phisn/DigitalDetectives/Architecture/Device_Layer_Detail.jpeg

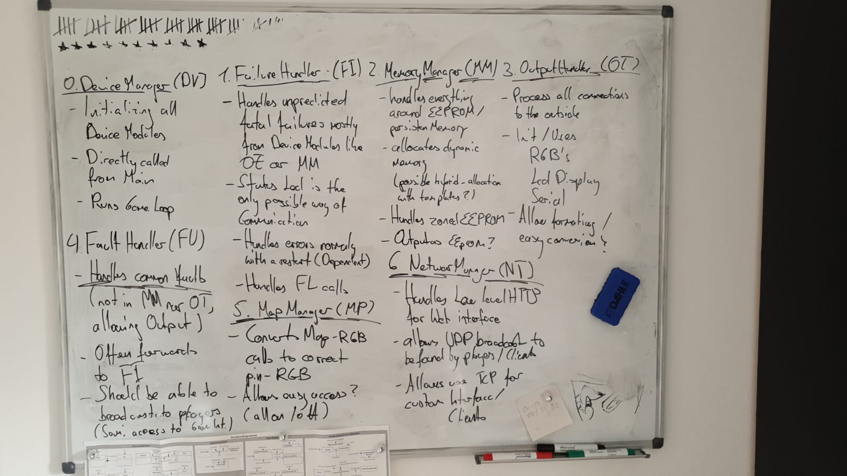
Architecture/Device_Layer_Detail.jpeg
