phisn/DigitalDetectives/Architecture/Combined_Layers.jpeg

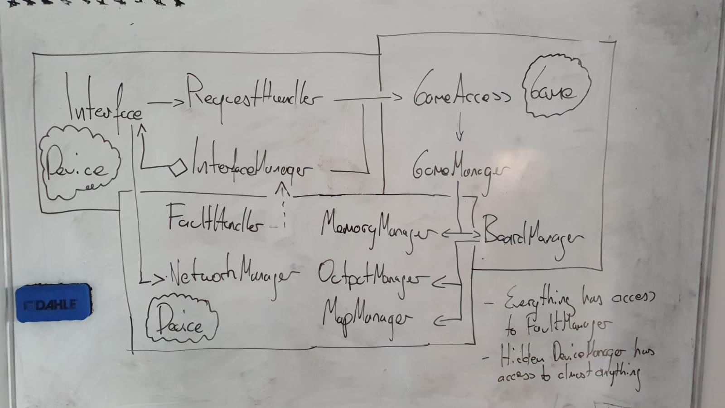
Architecture/Combined_Layers.jpeg
