phisn/DigitalDetectives/Architecture/BootConcept.jpeg

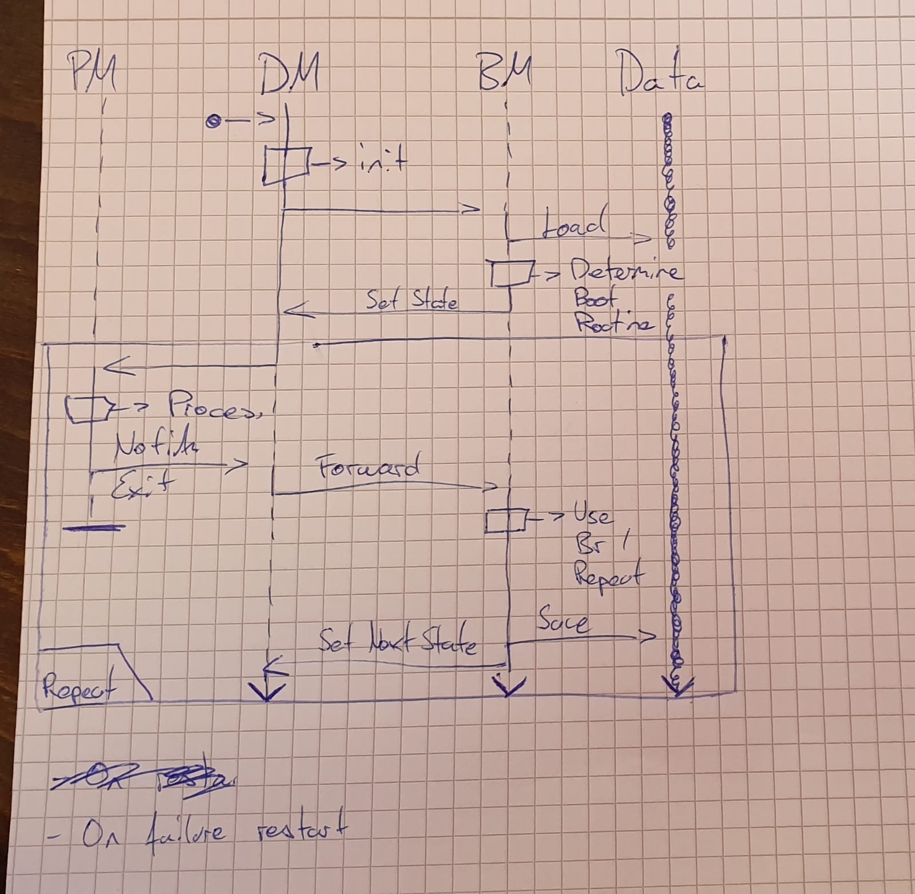
Architecture/BootConcept.jpeg
