phisn/DigitalDetectives/Architecture/Communication_Layer.jpeg

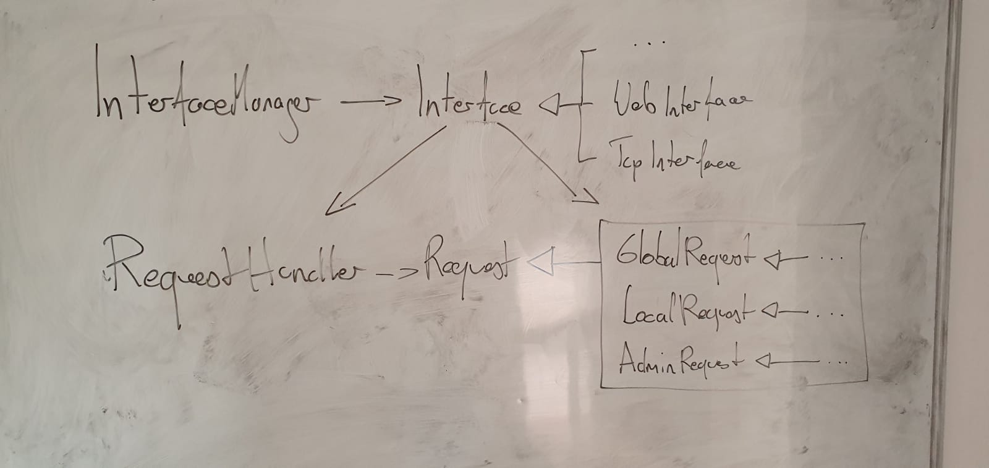
Architecture/Communication_Layer.jpeg
