phisn/DigitalDetectives/Architecture/Device_Layer.jpeg

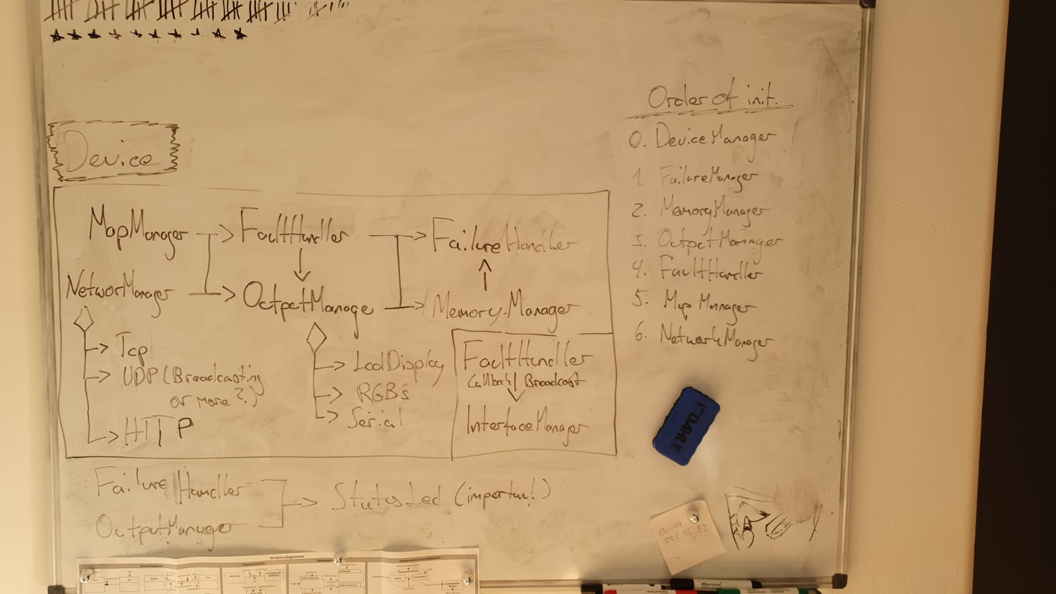
Architecture/Device_Layer.jpeg
