phisn/DigitalDetectives/Architecture/Game_Layer2.jpeg.jpg

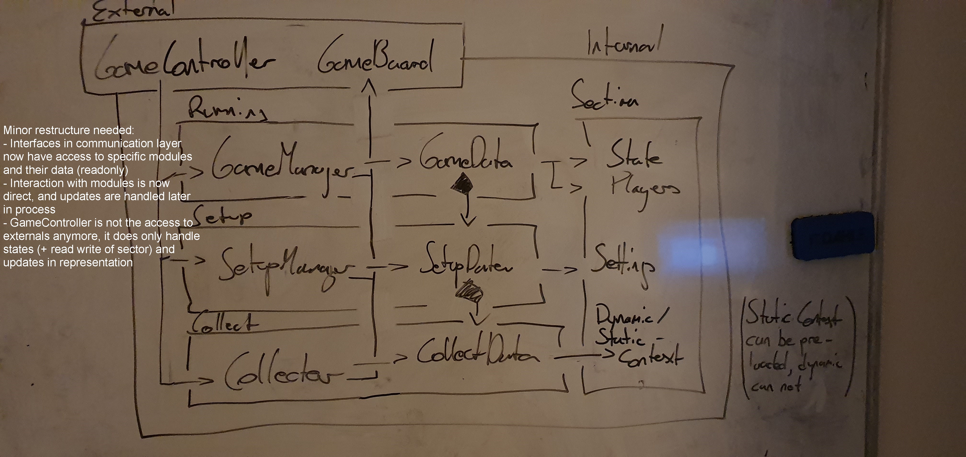
Architecture/Game_Layer2.jpeg.jpg
