phisn/DigitalDetectives/Architecture/Game_Layer.jpeg

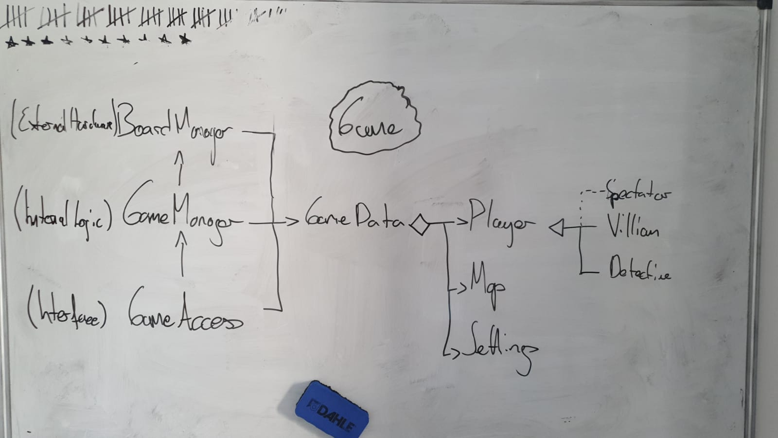
Architecture/Game_Layer.jpeg
