phisn/DigitalDetectives/Architecture/Overall_Progress.jpeg

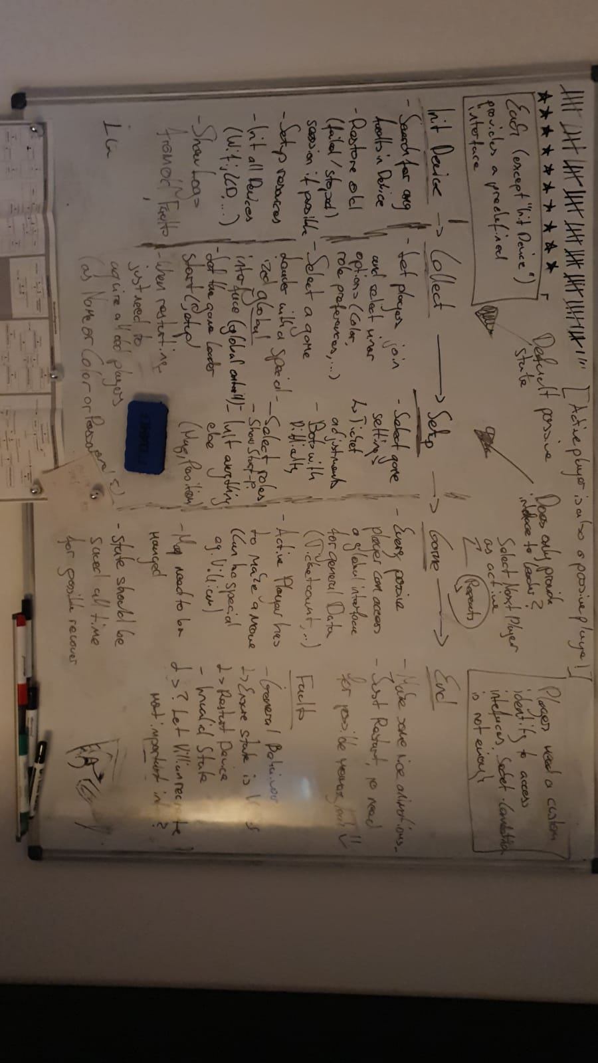
Architecture/Overall_Progress.jpeg
