phisn/DigitalDetectives/Docs/SY_Map.png

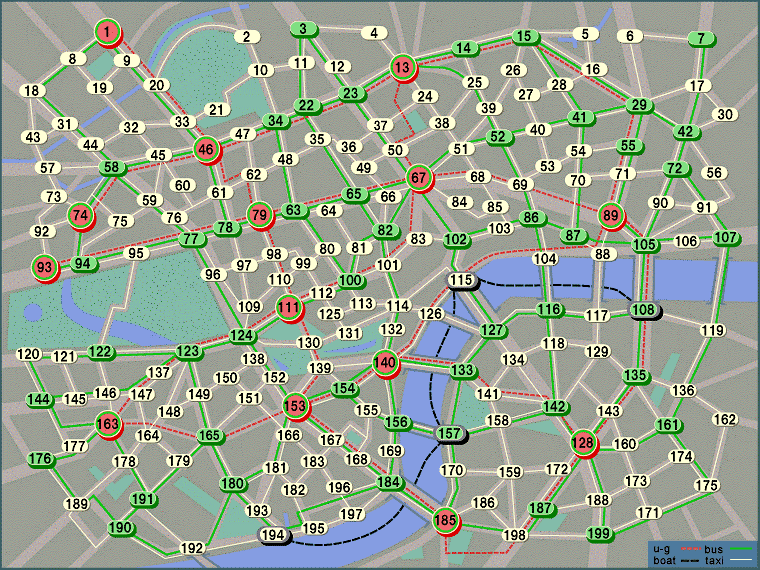
Docs/SY_Map.png
