phisn/DigitalDetectives/Docs/SY_Map_Splitted.jpeg

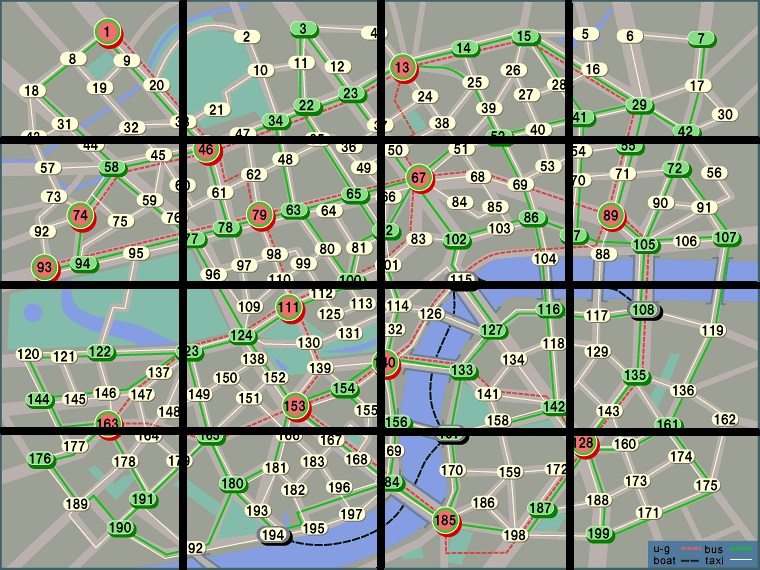
Docs/SY_Map_Splitted.jpeg
