phisn/DigitalDetectives/Source/Web/Modular/setup_body.txt

<body> <div class="container"> <h3>Please wait...</h3> <i>Your Player-ID is <b id="pid"></b></i> </div></body>
