phisn/DigitalDetectives/(commit log)

2019-08-15 Device Layer Initialize
2019-08-22 Global Namespace and Include fix
    [Main.ino]
2019-09-04 MemoryManger update, PathManger rename, general bug fixs
    [Main.ino]
2019-09-04 Bootmanager init, FaultHandler device validation init
2019-09-04 BootManager update, FaultHandler Report init & Validate update, DeviceManager Forward
2019-09-19 Fixed Typo in DeviceManager (InitializeGame)
2019-09-19 Added Current Villian Position to Web
2019-09-20 MememoryManager update, Outpmanager and Networkmanager Object error fix, DebugMessages
    [Main.ino]
2019-10-14 Interfacemanager fault notifier update, Interfacemanager process update including DeviceManager processing
2019-10-19 Boardmanager repr. update + Process, GameData major restructure affecting GameManager and PathManager, PathManager big update -> color and position, MapManager table reconverted
2019-11-18 lwop v2 -> v1.4, maybe tcp max con fixed
    [Main.ino]
2019-11-19 Conversion from ESP8266 -> ESP32 (40kb ram -> 240kb ram)
2019-11-21 WebHandlerRunning update / Fix, WEbInterface fix, BoardManager dirty Hotfix, still crashing :D
2019-11-23 WebInterface fix, WebHandler big update, Gamemanager fix begin, DEvice update
    [Main.ino]
2019-11-24 Outputmanager led fix -> external in main.ino, Pathmanager fix
    [Main.ino]
2019-11-26 OutputManager update (Selection), Outputmanager Choice implemented, Main.ino fix, Other fixes
    [Main.ino]
2019-11-27 Implemented RequestPlayerId, futher bug fixing, enabled to restore states, update to choice system, able to chose weather to restore
    [Main.ino]
2019-11-28 Web invalid socket state fix
2019-12-12 Websiteconstructor, Botinterface init, Lcdaccess setup update, General Device / Game fixes
    [Main.ino]
2019-12-15 Boardmanager running updatel, Boardmanager Animation create, Minor fixes
    [Main.ino]
